rocketman051894/LoraSMS/Hardware/Power Analsys.xlsx

Device | Current (mA) | Voltage | Power
ATMega | 12 | 5 | 0.06
Lora | 130 | 3.3 | 0.429
BT | 30 | 5 | 0.15
Total | 172 |  | 0.639
