rocketman051894/LoraSMS/Hardware/BOM.xls

Quantity | Designator | Description | Manufacturer | Manufacturer P/N
4 | C1, C3, C4, C5 | CAP, CER, SMT, 25V, +/- 10%, X7R, 0603 | Kemet Corporation | C0603C104K3RAC
4 | C2, C3, C8, C9 | CAP, CER, SMT, 1.0UF, 25V, 10%, X5R, 0603 | Kemet Corporation | C0603C105K3PAC
2 | C6, C7 | CAP, CER, 10%, 50V, 27PF, CAP0603 | Kemet Corporation | C0603C270K5GAC
4 | C10, C11, C17, C18 | CAP, CER, 10UF, 16V, X5R, 0805 | Murata Manufacturing Co., Ltd. | GRM21BR61C106KE15L
1 | C12 | CAP, CER, 0805, 20%, 6.3V, X5R, 47UF | Kemet Corporation | C0805C476M9PACTU
1 | C13 | CAP, CER, 5%, 25V, C0G, 0603, 10,000PF | TDK Corporation | C1608C0G1E103JT
2 | C14, C15 | CAP, CER, 0805, 20%, 10V, X7R, 22UF | Taiyo Yuden USA, Inc. | LMK212BJ226MG-T
1 | C16 | CAP RF, HIQ, NPO, +/-1%, 10GHZ, 200, 100V, 0603, 10PF, ROHS | Vishay | VJ0603D100FXBA
1 | C19 | CAP, CER, SMT, 25V, +80/-20%,Y5V,0603,.1uf | Kemet Corporation | C0603C104M3VAC
1 | D1 | DIODE, LED, RED, SMT, 2.5V, 0603 | Kingbright | APT1608SRCPRV
7 | FB1, FB2, FB3, FB4, FB5, FB6, FB7 | FERRITE,100MHZ,0603,25%,120OHM ROHS | Murata | BLM18PG121SN1D
1 | J1 | CONN, SMA JACK, FEMALE, EDGE | LINX | CONSMA003.062
1 | J2 | CONN USB 2.0 TYPE-C R/A SMT | GCT | USB4110-GF-A
2 | L1, L2 | INDUCTOR POWER 1UH 1.5A SMD | Vishay Dale | IHHP0806AZER1R0M01
2 | LED1, LED2 | LED 0603 SMD Green 570nm 50mcd 20mA | Wurth Electronics | 150060VS75000
2 | M1, M2 | MOSFET N-CH 30V 14A POWER56 | ON Semiconductor | FDMS7692
4 | MH1, MH2, MH3, MH4 | Mounting Hole
1 | P1 | Header, 3-Pin, Dual row
1 | P2 | HC-05 BLUETOOTH MODULE
1 | Q1 | TRANS,BJT,PNP,3906,SOT-23 | Fairchild Semiconductor | MMBT3906
2 | R1, R24 | RES, THICK FILM CHIP, SMT, 1/10W, 1%, 0603, 100K OHM | Panasonic Electronic Devices, Corp. | ERJ3EKF1003V
17 | R2, R3, R5, R6, R7, R8, R9, R10, R11, R12, R13, R14, R15, R16, R17, R27, R32 | RES, THICK FILM CHIP, 1/16W, 1%, RES0402, 0 OHM, ROHS, SHORT-IN-PAD! | Vishay-Dale Intertechnology, Inc | CRCW04020000Z0ED
2 | R4, R29 | RES, THICK FILM CHIP, SMT, 1/10W, 5%, 0603, 10K OHM | Vishay-Dale Intertechnology, Inc | CRCW060310K0JNEA
1 | R18 | RES, 1/10W, 5%, 0603, I MEG | KOA-Speer Electronics, Inc. | RM73B1JT105J
1 | R19 | RES, 1/8W, 5%, 0805, 330 OHM | KOA-Speer Electronics, Inc. | RM73B2AT331J
2 | R20, R25 | RES, THICK FILM CHIP, SMT, 1/10W, 5%, 0603, 510 OHM | Panasonic Electronic Devices, Corp. | ERJ3GEYJ511V
1 | R21 | RES, 1/16 W, 1%, 0603, 330 OHM | Panasonic Electronic Devices, Corp. | ERJ-3ENF3300V
1 | R22 | RES, THICK FILM CHIP, SMT, 1/10W, 1%, 0603, 316K OHM | Panasonic Electronic Devices, Corp. | ERJ3EKF3163V
1 | R23 | RES, 1/10W, 5%, 0603, 2.2K OHM | KOA-Speer Electronics, Inc. | RM73B1JT222J
1 | R26 | RES, 1/16W, 1%, 0603, 2.00K OHM | Panasonic Electronic Devices, Corp. | ERJ-3EKF2001V
2 | R28, R31 | RES, THICK FILM CHIP, SMT, 1/10W, 1%, 0603, 5.1 OHM | Panasonic Electronic Devices, Corp. | ERJ-3EKF5R1V
1 | R30 | RES, THICK FILM, CURRENT SENSE, 1/2 W, 1%, RES1206, 0.05 OHMS | TT Electronics, PLC | LRC-LR1206LF-01-R050-F
1 | R33 | RES,1/10W,1%,0603,100K OHM | Panasonic Electronic Devices, Corp. | ERJ-3EKF1003V
1 | R34 | RES, METAL FILM, 1/16W, .5%, 0603, SMD, 4.02K | Susumu | RR0816P-4021-D-59H
1 | SW1 | SWITCH SLIDE DPDT 300MA 6V | JS202011JAQN | C&K
1 | U1 | RFM69HCW WIRELESS TRANSCEIVER 91 | SparkFun | COM-13909
1 | U2 | 8-bit AVR Microcontroller, 32KB Flash, 1KB EEPROM, 2KB SRAM, 32-pin TQFP, Industrial Grade (-40°C to 85°C) | Microchip Technology | ATMEGA328PB-AU
1 | U3 | IC LI-ION/LI-POLY CTRLR SOT23-5 | Microchip Technology | MCP73812T-420I/OT
1 | U4 | TPS630242YFFR | TI | TPS630242YFFR
1 | U5 | HOLDER BATTERY 1CELL 18650 SMD | Keystone Electronics | 1042
1 | U6 | TPS61230ARNSR | TI | TPS61230ARNSR
1 | U7 | IC LITHIUM BATT PROTECT 6-SON | Texas instruments | BQ29702DSER
1 | U8 | LOW COST CURRENT SENSOR WITH COM | TI | INA381A3IDSGR
1 | Y1 | CRYSTAL 16.0000MHZ 8PF SMD
