rocketman051894/LoraSMS/Hardware/Digikey Cart 2019-09-24T211540.xlsx

Index | Quantity | Part Number | Manufacturer Part Number | Description | Customer Reference | Available | Backorder | Unit Price | Extended Price USD
1 | 4 | 399-7846-1-ND | C0603C105K3PACTU | CAP CER 1UF 25V X5R 0603 |  | 4 | 0 | 0.21 | 0.84
2 | 2 | 399-7889-1-ND | C0603C270K5GACTU | CAP CER 27PF 50V C0G/NP0 0603 |  | 2 | 0 | 0.1 | 0.20
3 | 4 | 490-3886-1-ND | GRM21BR61C106KE15L | CAP CER 10UF 16V X5R 0805 |  | 4 | 0 | 0.32 | 1.28
4 | 1 | 399-5506-1-ND | C0805C476M9PACTU | CAP CER 47UF 6.3V X5R 0805 |  | 1 | 0 | 0.94 | 0.94
5 | 2 | 587-1958-1-ND | LMK212BJ226MG-T | CAP CER 22UF 10V X5R 0805 |  | 2 | 0 | 0.45 | 0.90
6 | 1 | 754-1122-1-ND | APT1608SRCPRV | LED RED CLEAR CHIP SMD |  | 1 | 0 | 0.38 | 0.38
7 | 1 | CONSMA003.062-ND | CONSMA003.062 | CONN SMA RCPT STR 50OHM EDGE MNT |  | 1 | 0 | 3.76 | 3.76
8 | 1 | 2073-USB4110-GF-A-1-ND | USB4110-GF-A | CONN USB 2.0 TYPE-C R/A SMT |  | 1 | 0 | 1.37 | 1.37
9 | 2 | 541-2647-1-ND | IHHP0806AZER1R0M01 | FIXED IND 1UH 3.1A 65 MOHM SMD |  | 2 | 0 | 0.42 | 0.84
10 | 2 | 732-4980-1-ND | 150060VS75000 | LED GREEN CLEAR 0603 SMD |  | 2 | 0 | 0.14 | 0.28
11 | 2 | FDMS7692CT-ND | FDMS7692 | MOSFET N-CH 30V 14A POWER56 |  | 2 | 0 | 0.66 | 1.32
12 | 2 | P100KHCT-ND | ERJ-3EKF1003V | RES SMD 100K OHM 1% 1/10W 0603 |  | 2 | 0 | 0.1 | 0.20
13 | 2 | 541-10KGCT-ND | CRCW060310K0JNEA | RES SMD 10K OHM 5% 1/10W 0603 |  | 2 | 0 | 0.1 | 0.20
14 | 1 | A130109CT-ND | CRGCQ0603J1M0 | CRGCQ 0603 1M0 5% |  | 1 | 0 | 0.1 | 0.10
15 | 1 | CR0603-JW-331ELFCT-ND | CR0603-JW-331ELF | RES SMD 330 OHM 5% 1/10W 0603 |  | 1 | 0 | 0.1 | 0.10
16 | 2 | P510GCT-ND | ERJ-3GEYJ511V | RES SMD 510 OHM 5% 1/10W 0603 |  | 2 | 0 | 0.1 | 0.20
17 | 10 | CR0603-JW-331ELFCT-ND | CR0603-JW-331ELF | RES SMD 330 OHM 5% 1/10W 0603 |  | 10 | 0 | 0.015 | 0.15
18 | 1 | P316KHCT-ND | ERJ-3EKF3163V | RES SMD 316K OHM 1% 1/10W 0603 |  | 1 | 0 | 0.1 | 0.10
19 | 1 | A130093CT-ND | CRGCQ0603J2K2 | CRGCQ 0603 2K2 5% |  | 1 | 0 | 0.1 | 0.10
20 | 1 | P2.00KHCT-ND | ERJ-3EKF2001V | RES SMD 2K OHM 1% 1/10W 0603 |  | 1 | 0 | 0.1 | 0.10
21 | 2 | RHM5.1DCT-ND | ESR03EZPJ5R1 | RES SMD 5.1 OHM 5% 1/4W 0603 |  | 2 | 0 | 0.1 | 0.20
22 | 1 | P18935CT-ND | ERJ-B2CFR05V | RES 0.05 OHM 1W 1206 WIDE |  | 1 | 0 | 0.68 | 0.68
23 | 1 | P100KHCT-ND | ERJ-3EKF1003V | RES SMD 100K OHM 1% 1/10W 0603 |  | 1 | 0 | 0.1 | 0.10
24 | 1 | RR08P4.02KDCT-ND | RR0816P-4021-D-59H | RES SMD 4.02KOHM 0.5% 1/16W 0603 |  | 1 | 0 | 0.11 | 0.11
25 | 1 | CKN10722CT-ND | JS202011JAQN | SWITCH SLIDE DPDT 300MA 6V |  | 1 | 0 | 0.51 | 0.51
26 | 1 | ATMEGA328PB-AU-ND | ATMEGA328PB-AU | IC MCU 8BIT 32KB FLASH 32TQFP |  | 1 | 0 | 1.38 | 1.38
27 | 1 | MCP73812T-420I/OTCT-ND | MCP73812T-420I/OT | IC LI-ION/LI-POLY CTRLR SOT23-5 |  | 1 | 0 | 0.56 | 0.56
28 | 1 | 296-40854-1-ND | TPS630242YFFT | IC REG BCK BST 3.3V 20DSBGA |  | 1 | 0 | 2.68 | 2.68
29 | 1 | 296-47375-1-ND | TPS61230ARNSR | IC REG BOOST ADJUSTABLE 6A 7VQFN |  | 1 | 0 | 1.82 | 1.82
30 | 1 | 296-39945-1-ND | BQ29702DSER | IC LITHIUM BATT PROTECT 6-SON |  | 1 | 0 | 0.69 | 0.69
31 | 4 | 399-1281-1-ND | C0603C104K3RACTU | CAP CER 0.1UF 25V X7R 0603 |  | 4 | 0 | 0.14 | 0.56
32 | 1 | 296-50476-1-ND | INA381A3IDSGR | LOW COST CURRENT SENSOR WITH COM |  | 1 | 0 | 0.75 | 0.75
33 | 1 | 311-1085-1-ND | CC0603KRX7R9BB103 | CAP CER 10000PF 50V X7R 0603 |  | 1 | 0 | 0.1 | 0.10
34 | 1 | 1276-CL10B104KB8NNNLCT-ND | CL10B104KB8NNNL | CAP CER 0.1UF 50V X7R 0603 |  | 1 | 0 | 0.1 | 0.10
35 | 1 | 311-1058-1-ND | CC0603JRNPO9BN100 | CAP CER 10PF 50V C0G/NPO 0603 |  | 1 | 0 | 0.1 | 0.10
36 | 1 | MMBT3906-TPCT-ND | MMBT3906-TP | TRANS PNP 40V 0.2A SOT23 |  | 1 | 0 | 0.14 | 0.14
37 | 1 | 36-1042P-ND | 1042P | BATTERY HOLDER 18650 SMD TAB |  | 1 | 0 | 2.76 | 2.76
38 | 10 | 490-1037-1-ND | BLM18PG121SN1D | FERRITE BEAD 120 OHM 0603 1LN |  | 10 | 0 | 0.076 | 0.76
