rocketman051894/LoraSMS/Mechanical/Bottom Case.stl

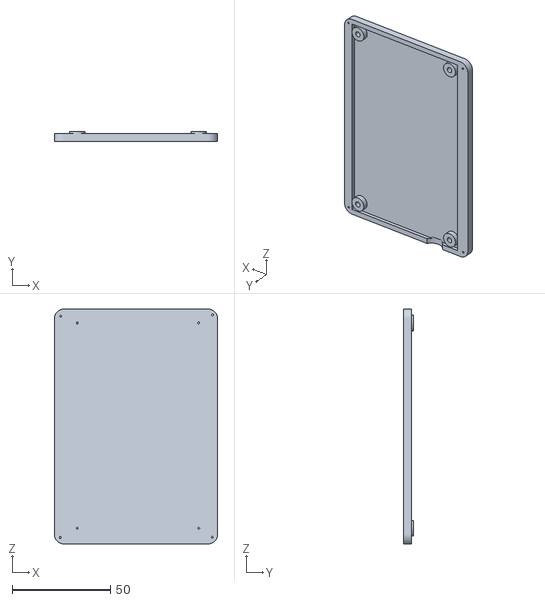
[picture p2: CAD file, 2021-03-16]
Mechanical/Bottom Case.stl
83.1 x 4.85 x 119.5
