rocketman051894/LoraSMS/Mechanical/Top Case.stl

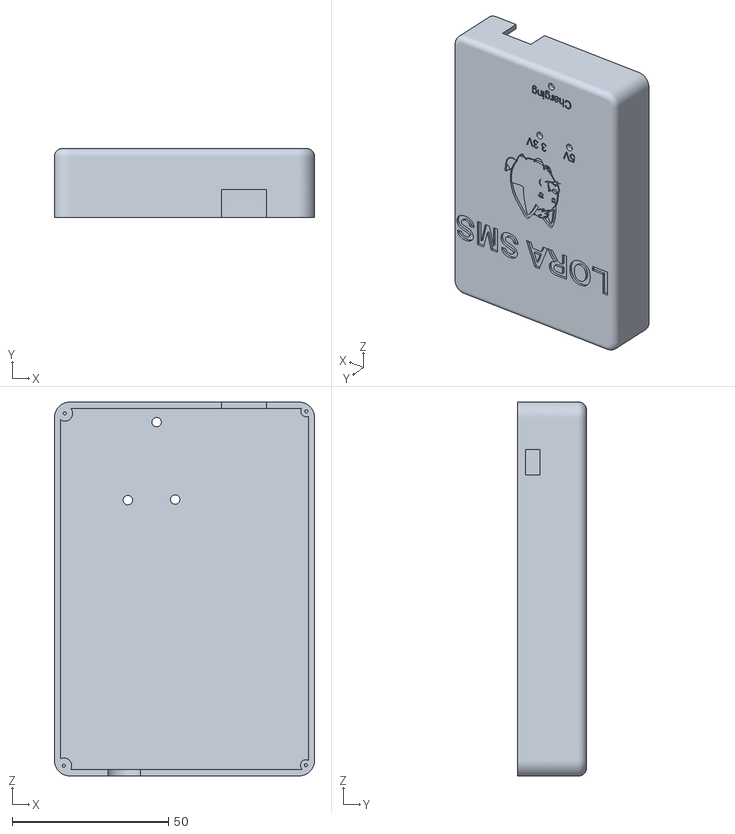
[picture p3: CAD file, 2021-03-16]
Mechanical/Top Case.stl
83.1 x 22.0 x 119.5
