rocketman051894/LoraSMS/Hardware/Schematic/Schematic_Schematic.PDF

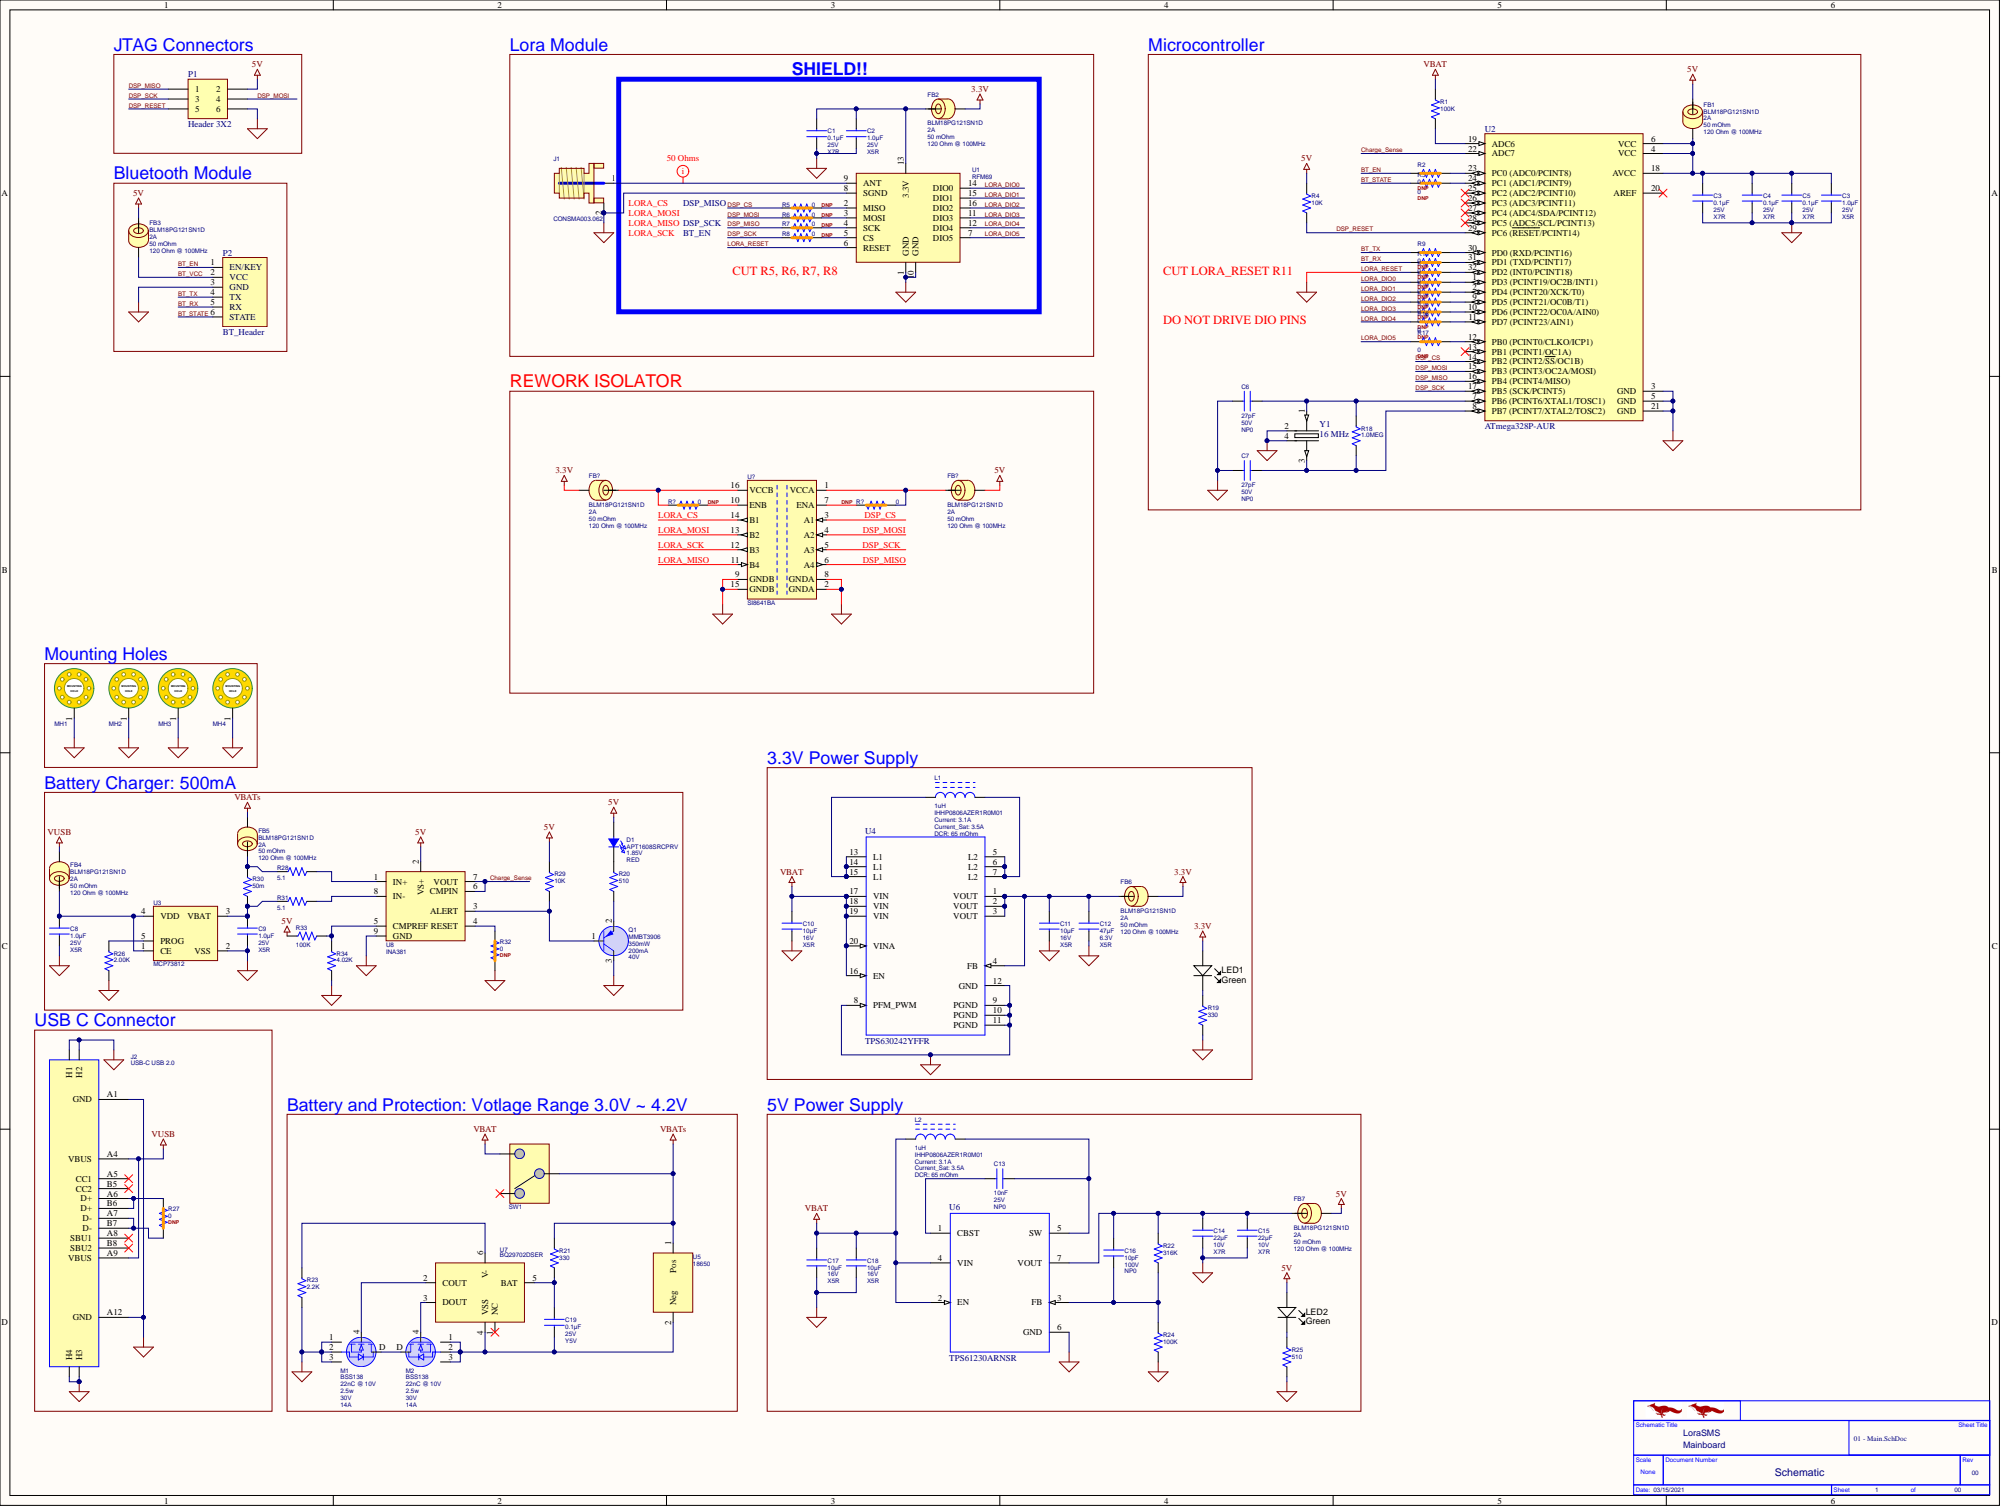
[picture p4: page 1]

GND 3

DO NOT DRIVE DIO PINS

MH1 HOLE | MH2 1 MOUNTING HOLE | MH3 1 MOUNTING HOLE | 1 MOUNTING HOLE

Battery and Protection: Votlage Range 3.0V ~ 4.2V

LoraSMS Schematic Title Mainboard | Sheet Title 01 - Main.SchDoc

Scale None | Document Number Schematic | Rev 00

Date: 03/15/2021 | Sheet 1 of 00
