rocketman051894/LoraSMS/Hardware/PCB/Assembly_Images/PCB_Assembly_Image_BW.PDF

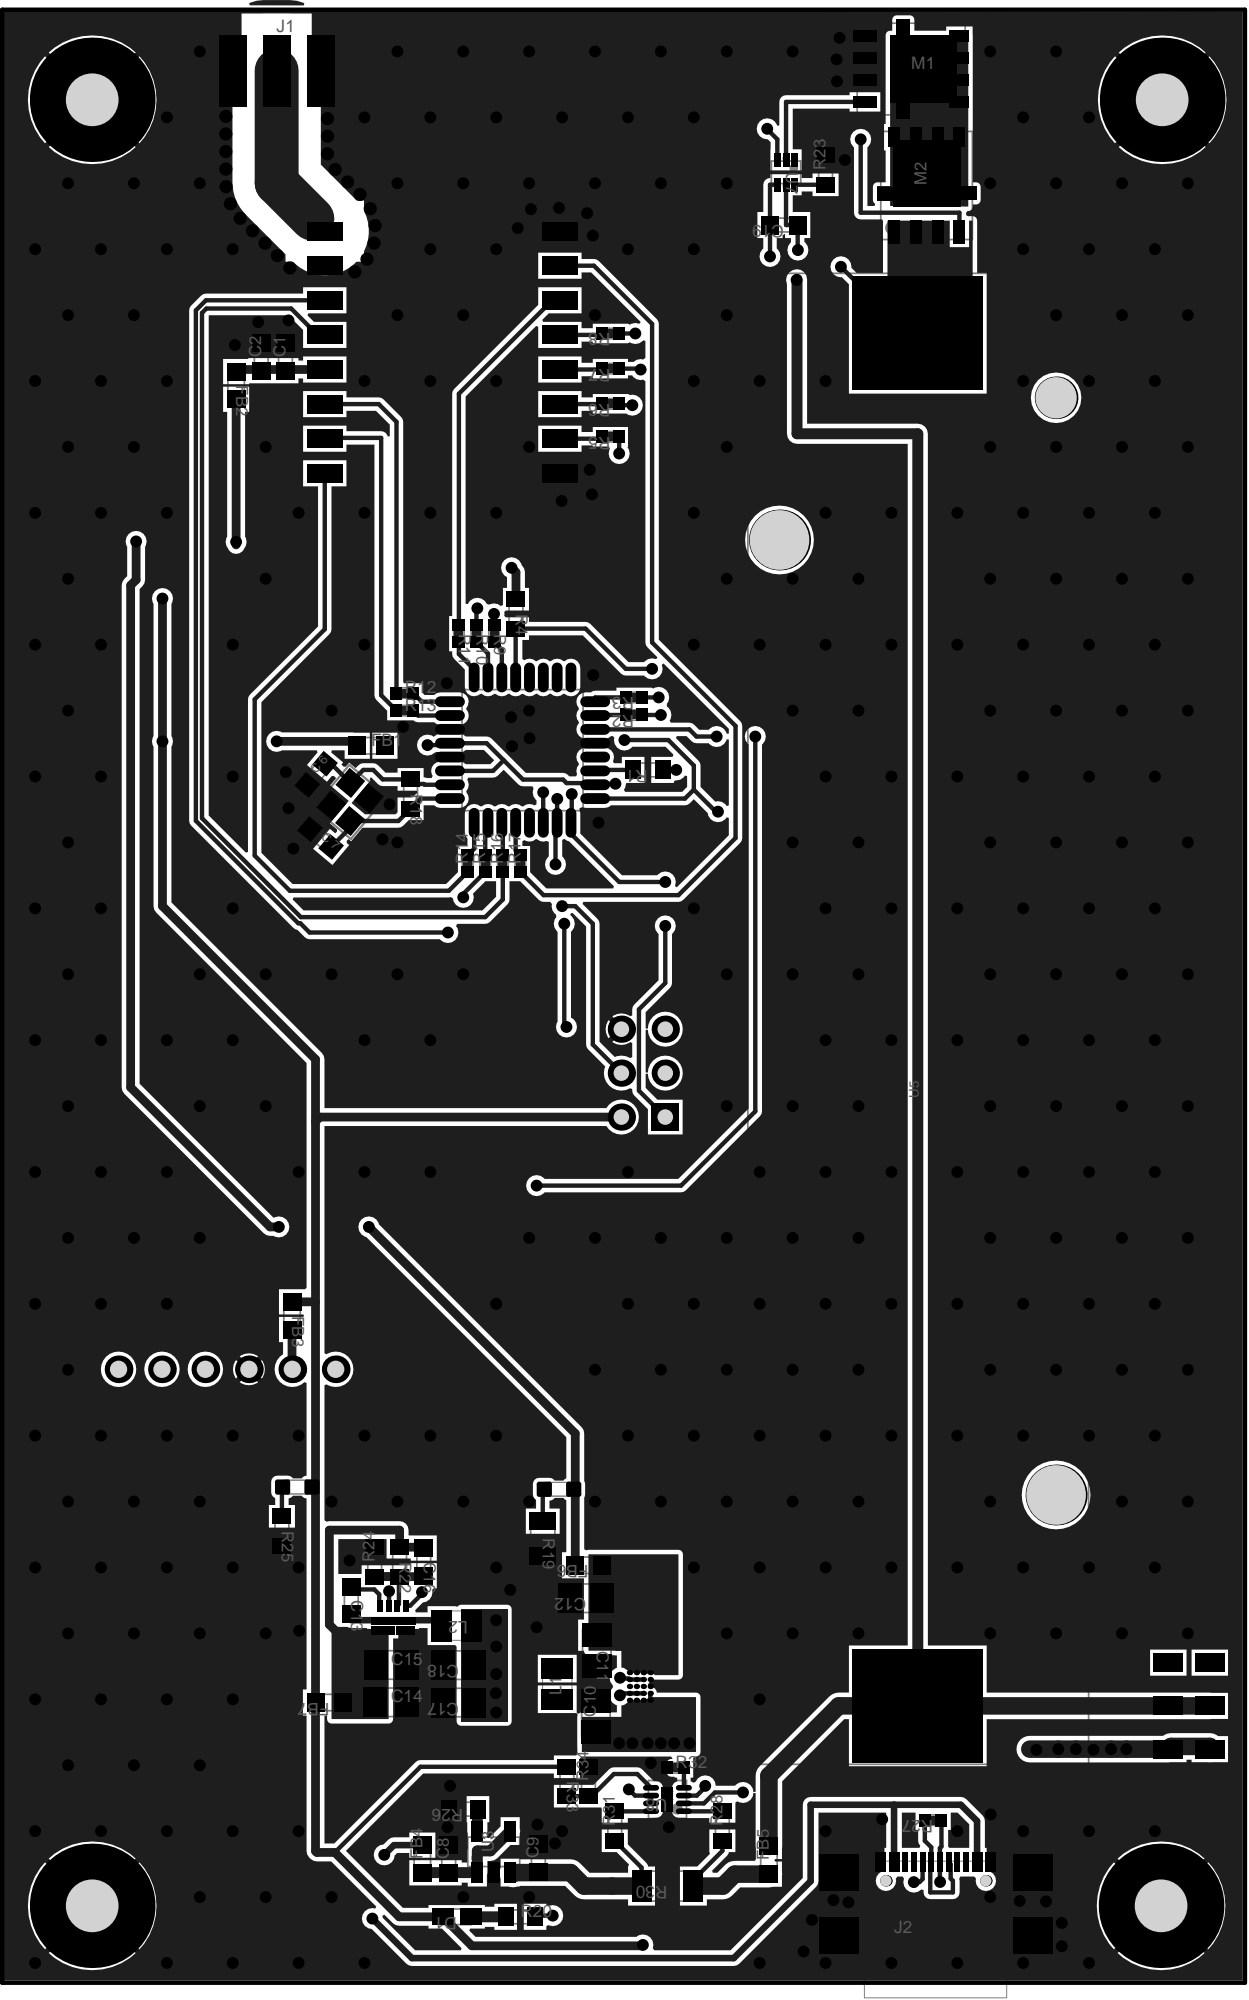
[picture p5: page 1]

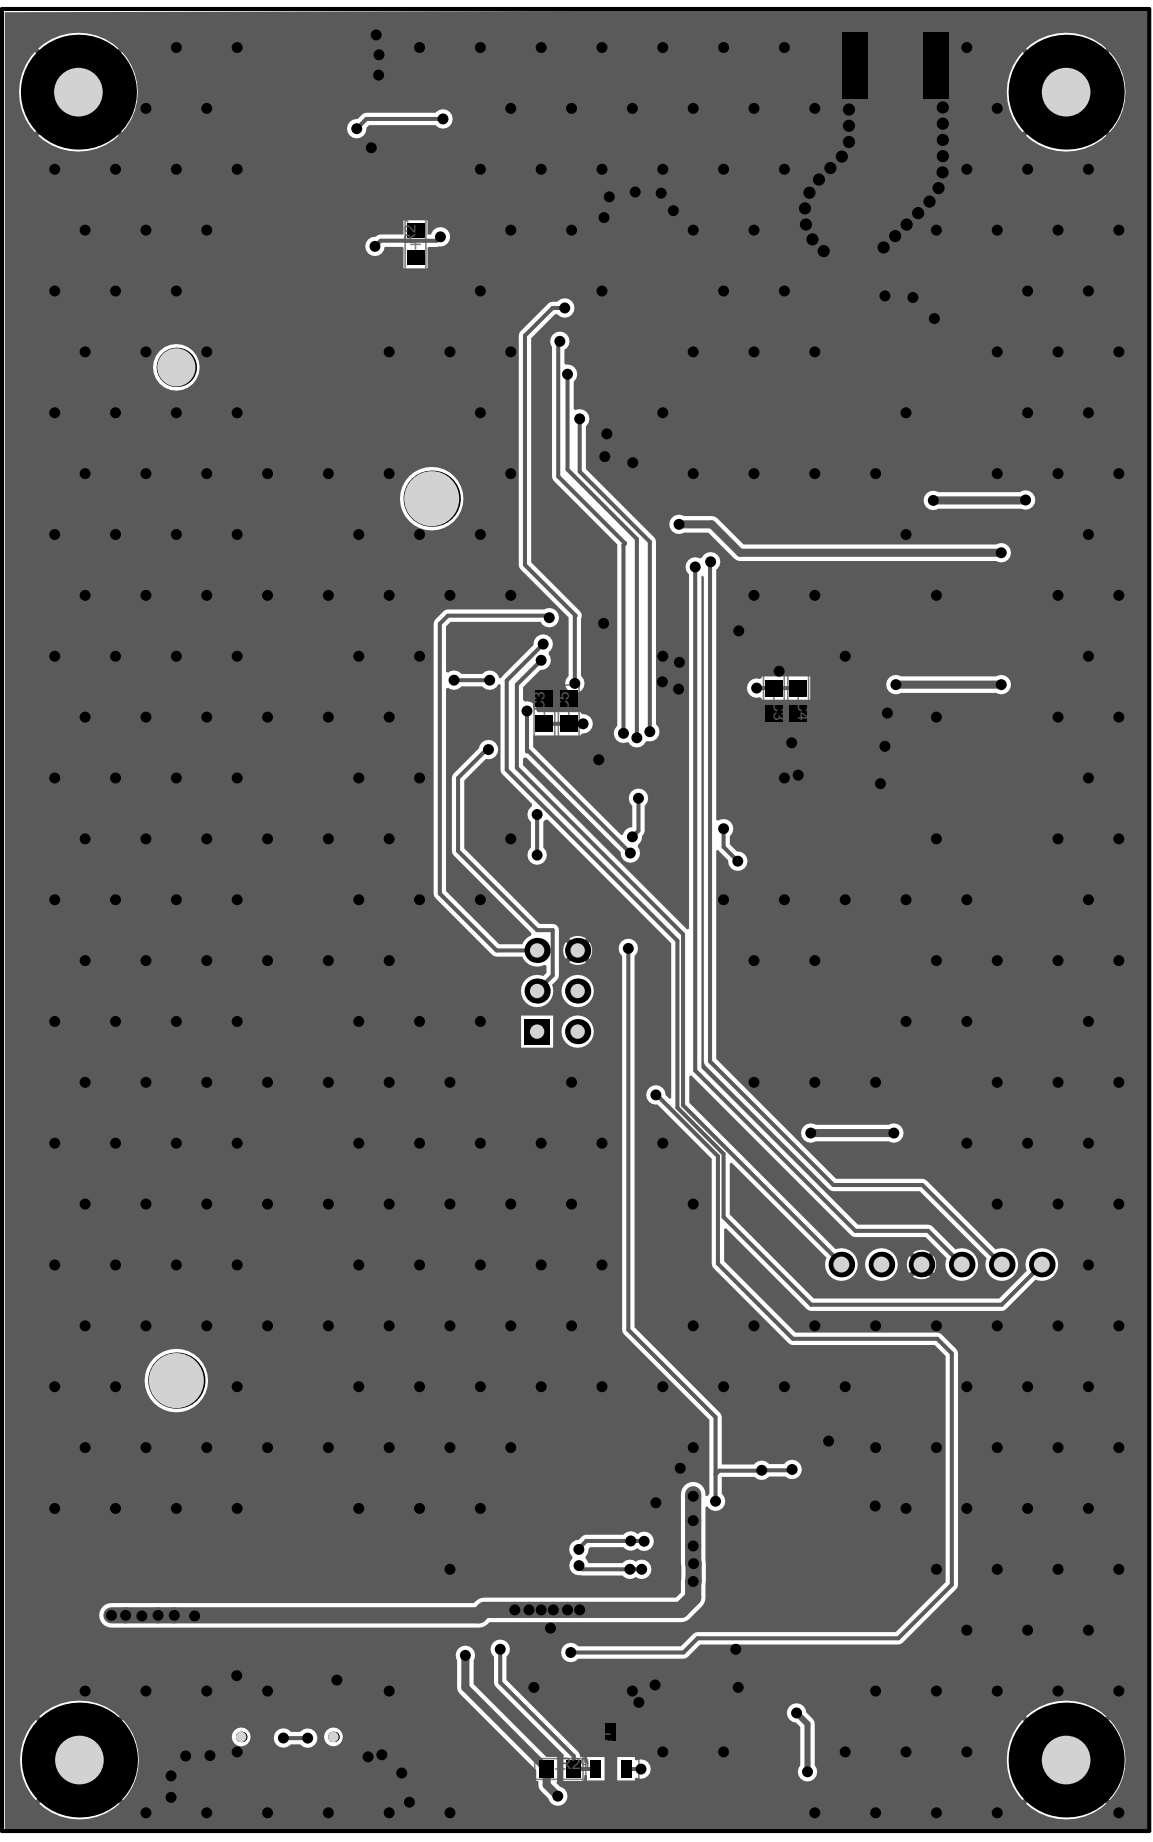
[picture p6: page 2]
