rocketman051894/LoraSMS/Hardware/PCB/Assembly_Images/PCB_Assembly_Image_BW_DNP.PDF

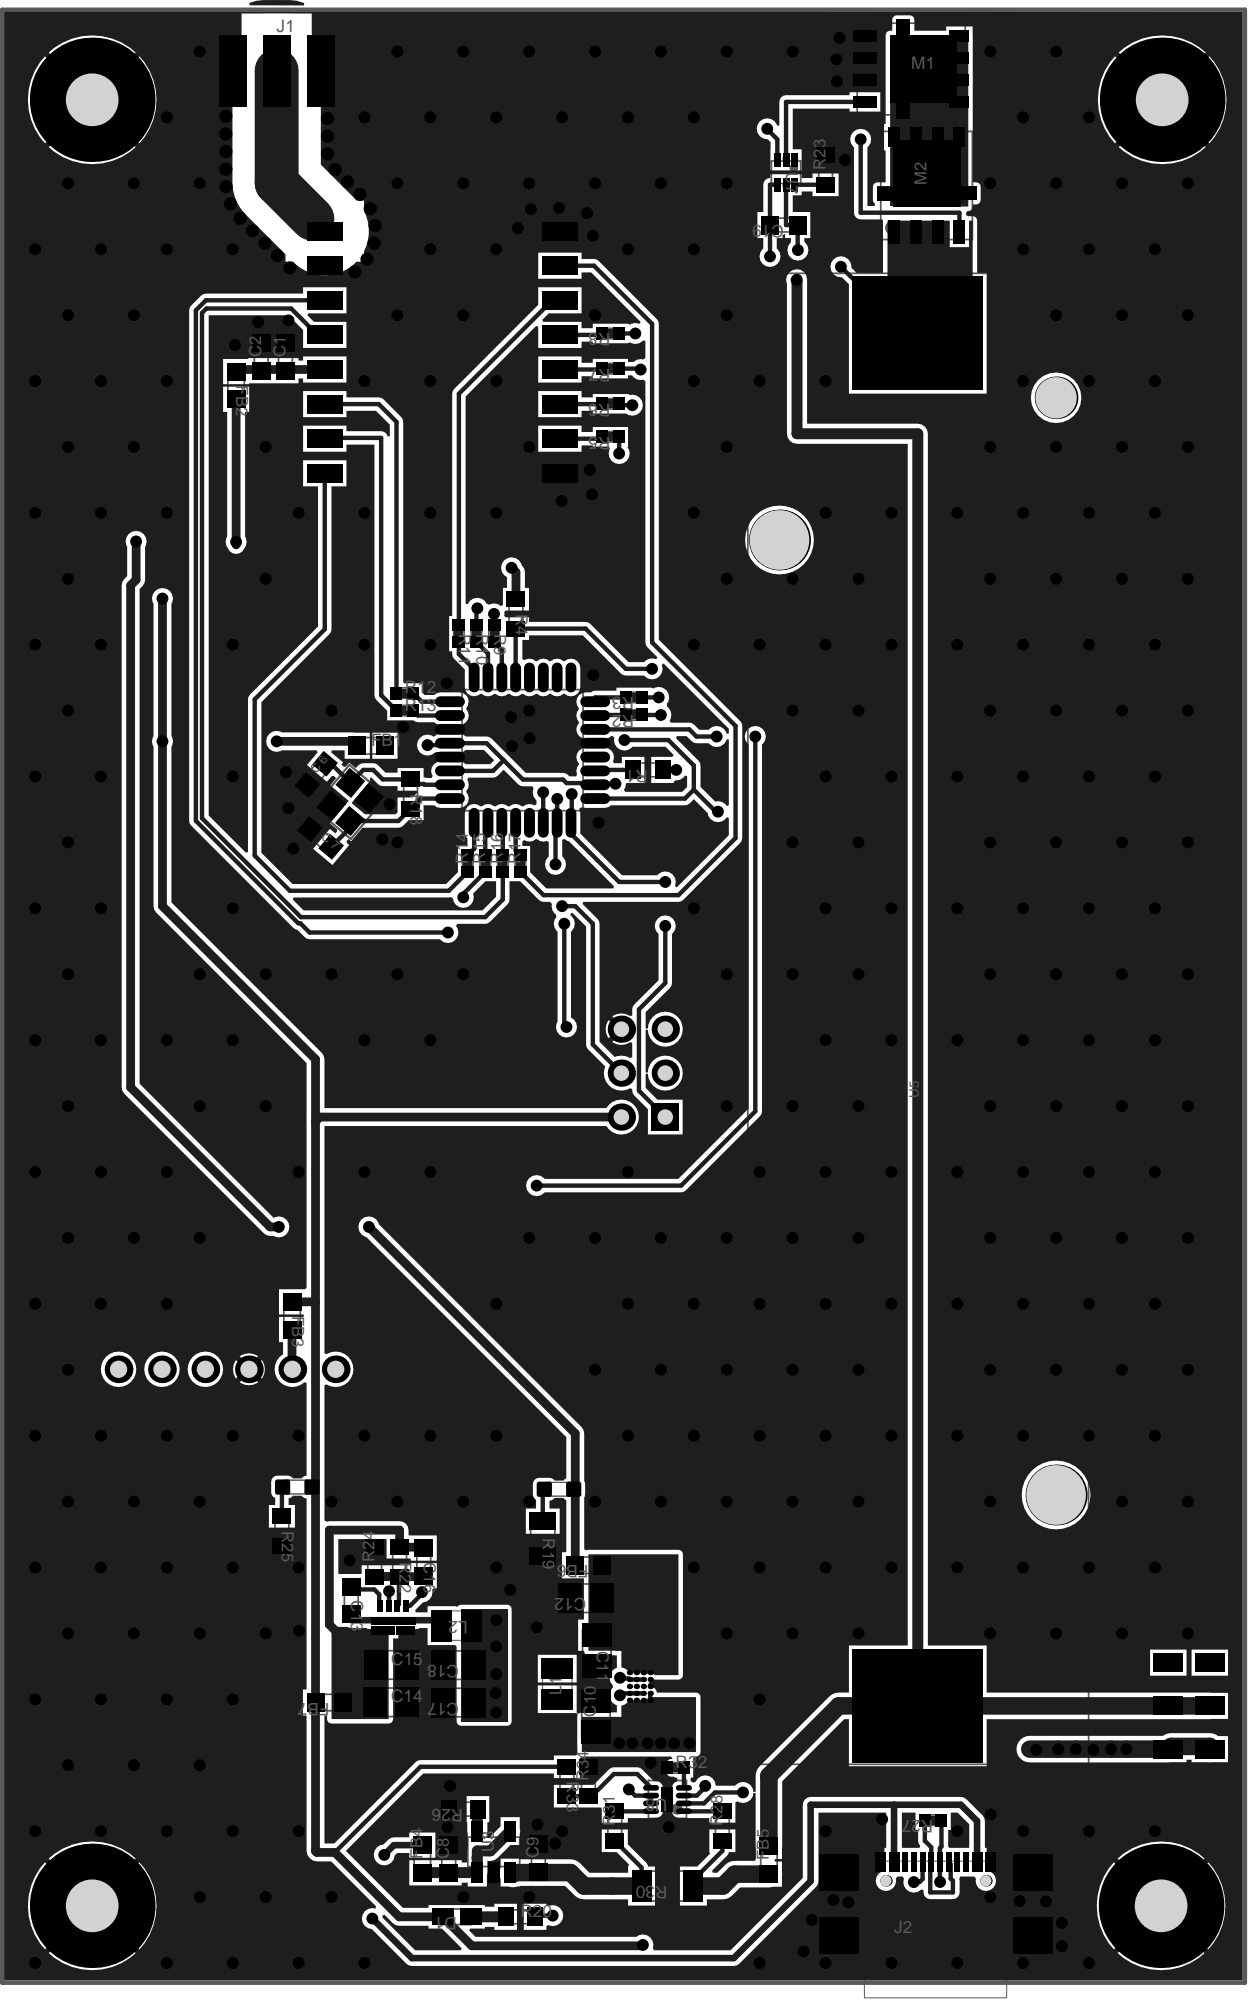
[picture p7: page 1]

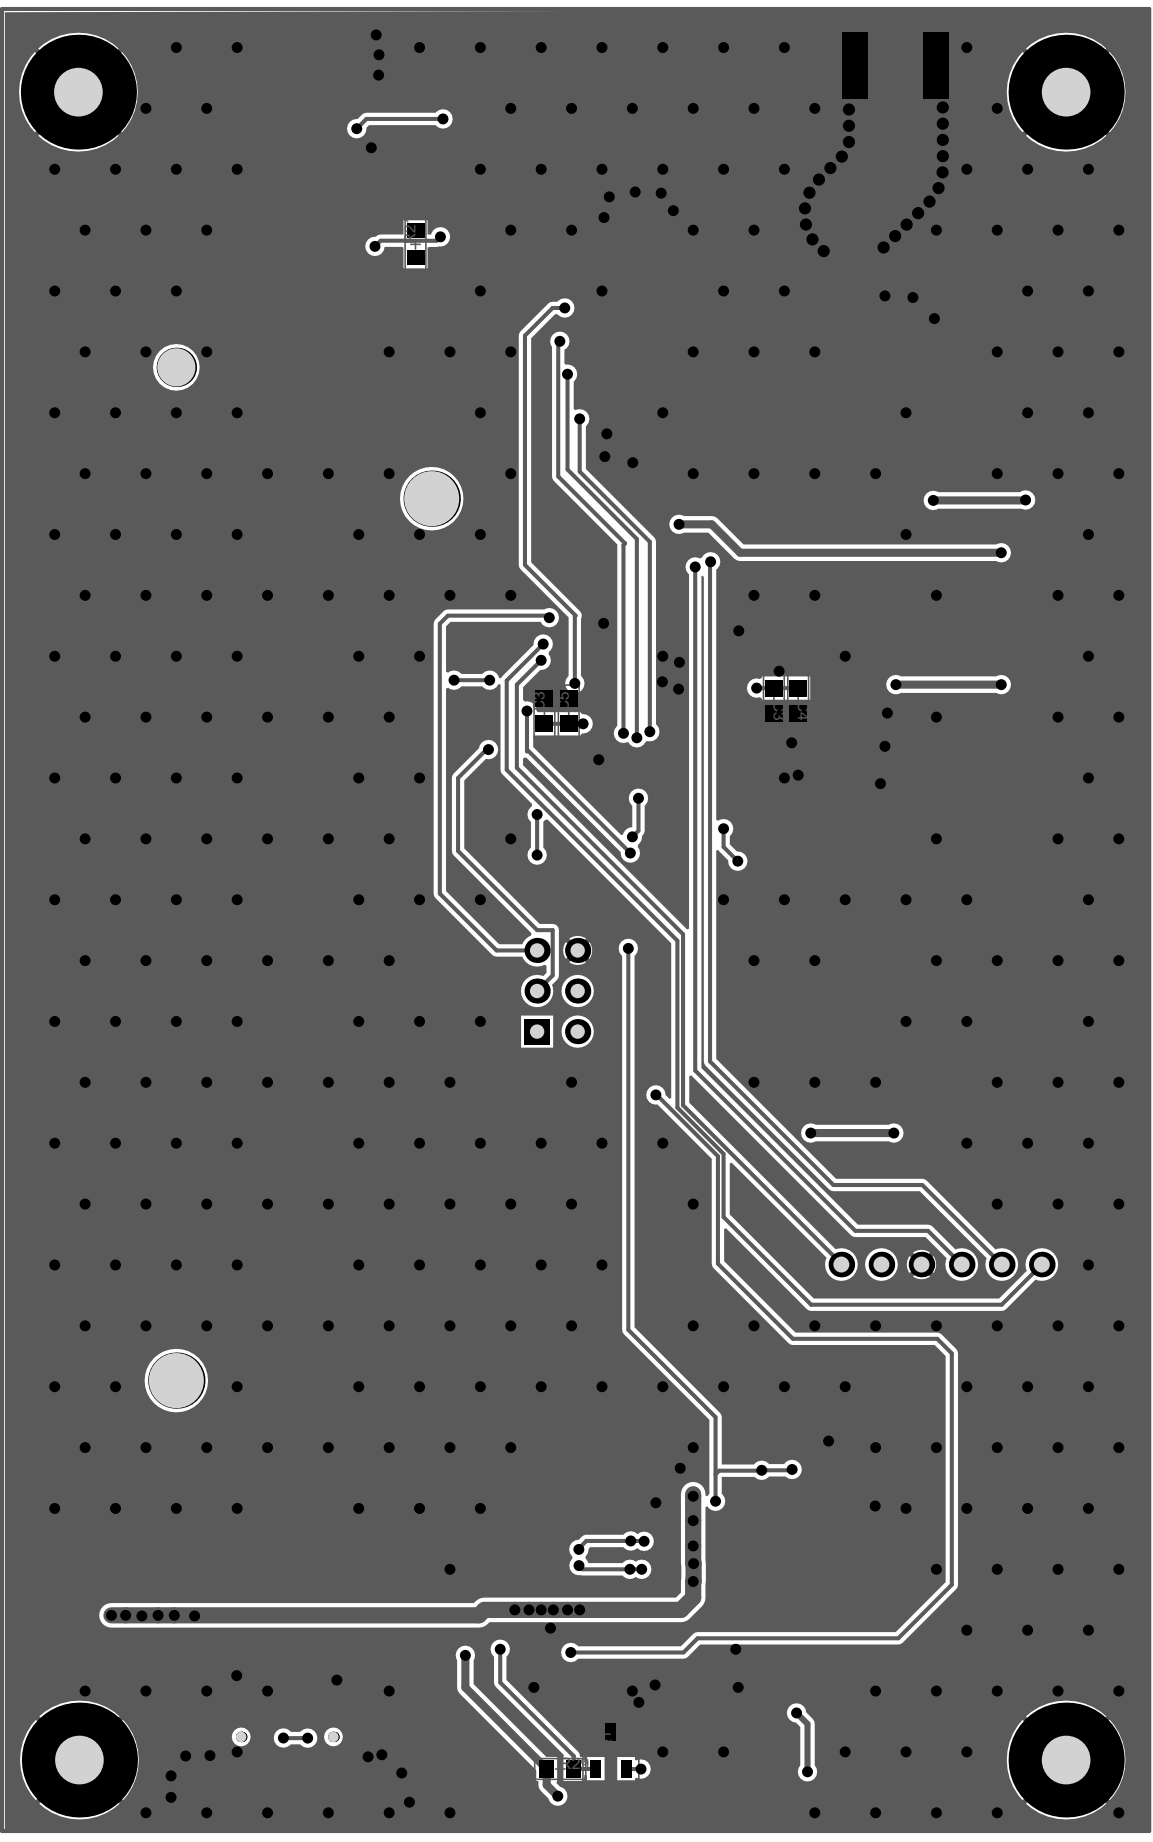
[picture p8: page 2]
