rocketman051894/LoraSMS/Hardware/PCB/Assembly_Images/PCB_Assembly_Image_Color.PDF

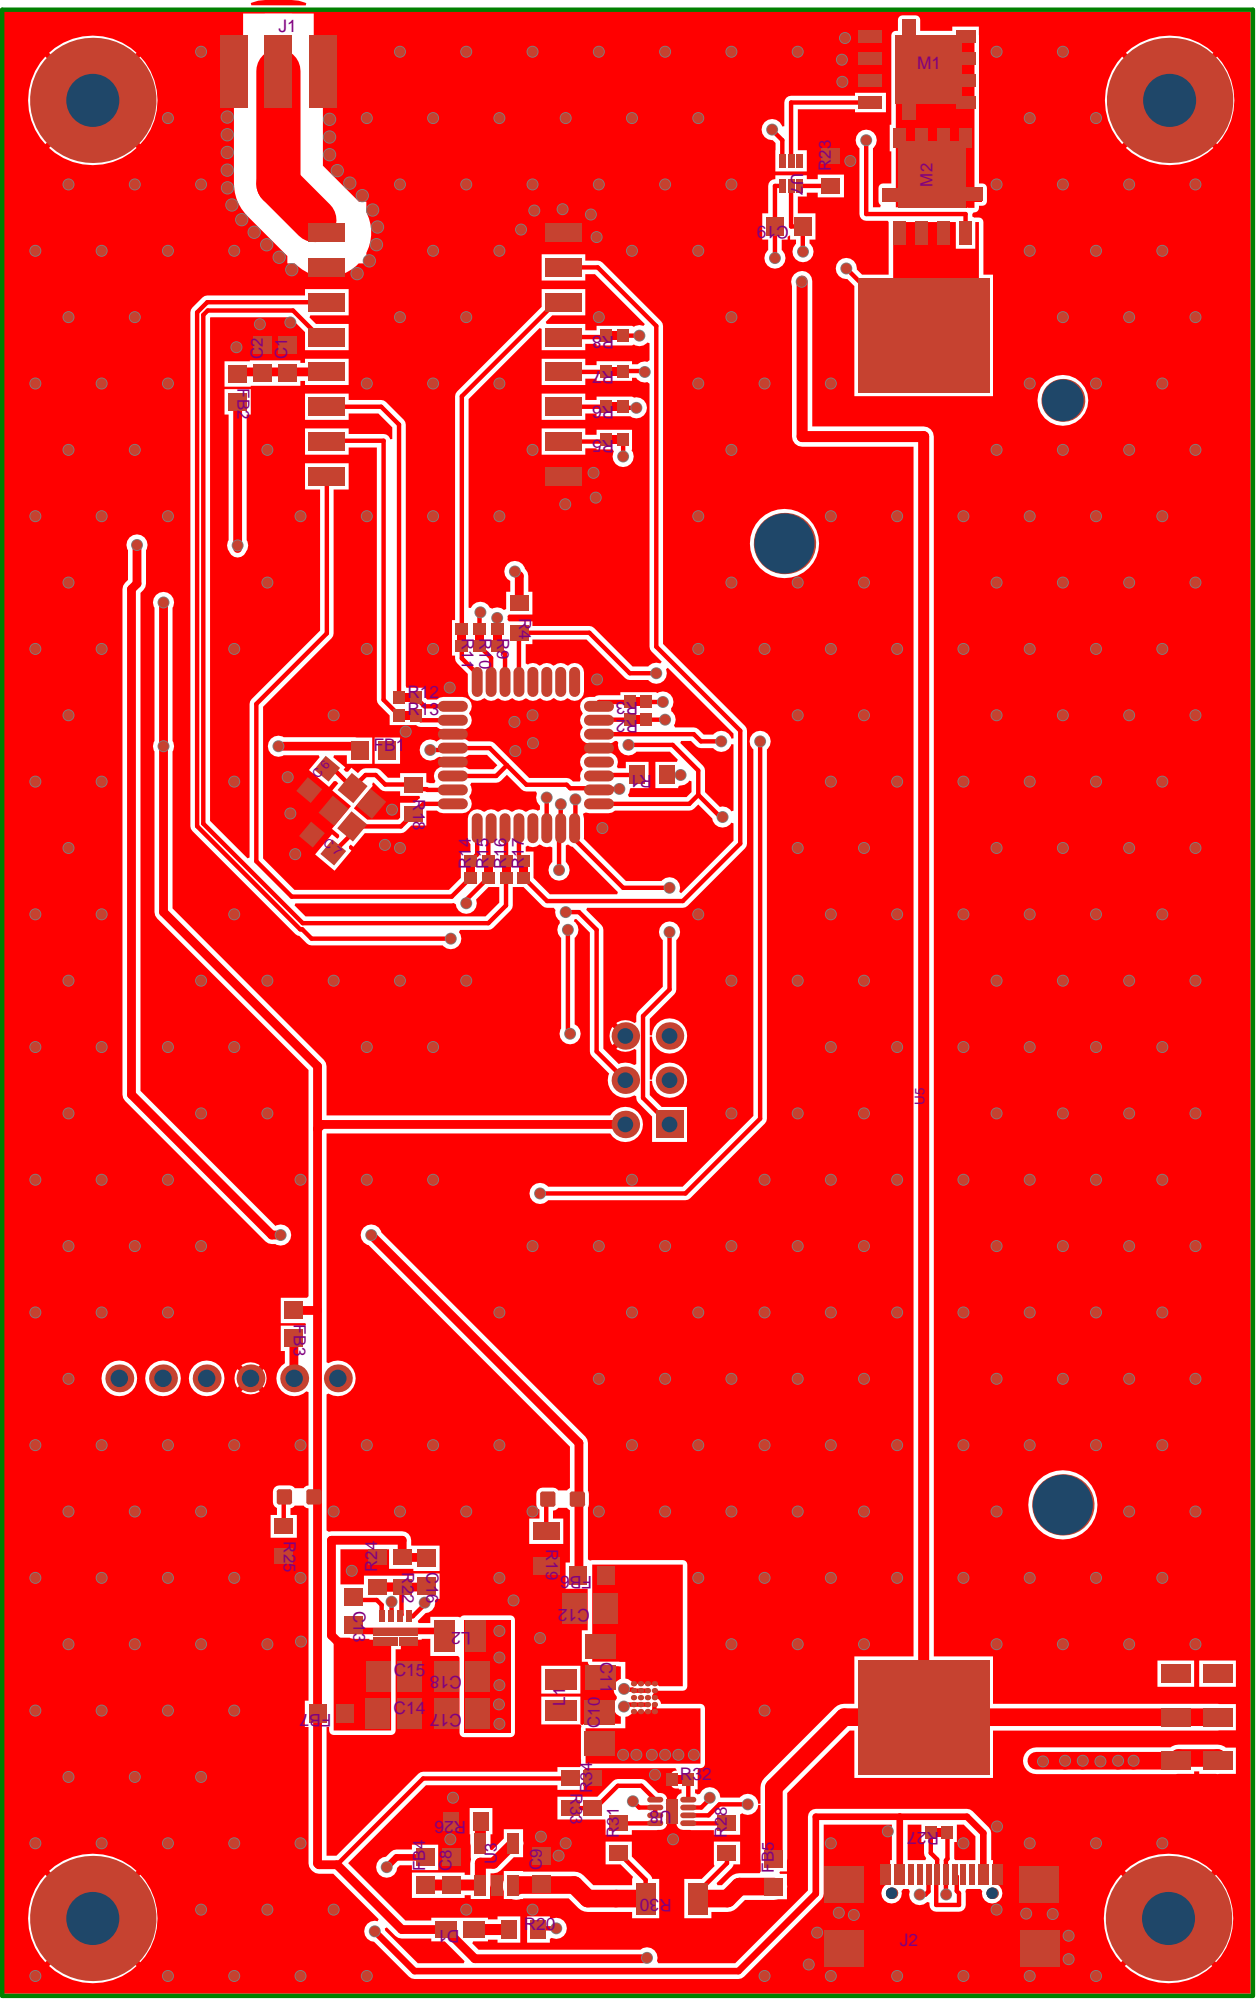
[picture p9: page 1]

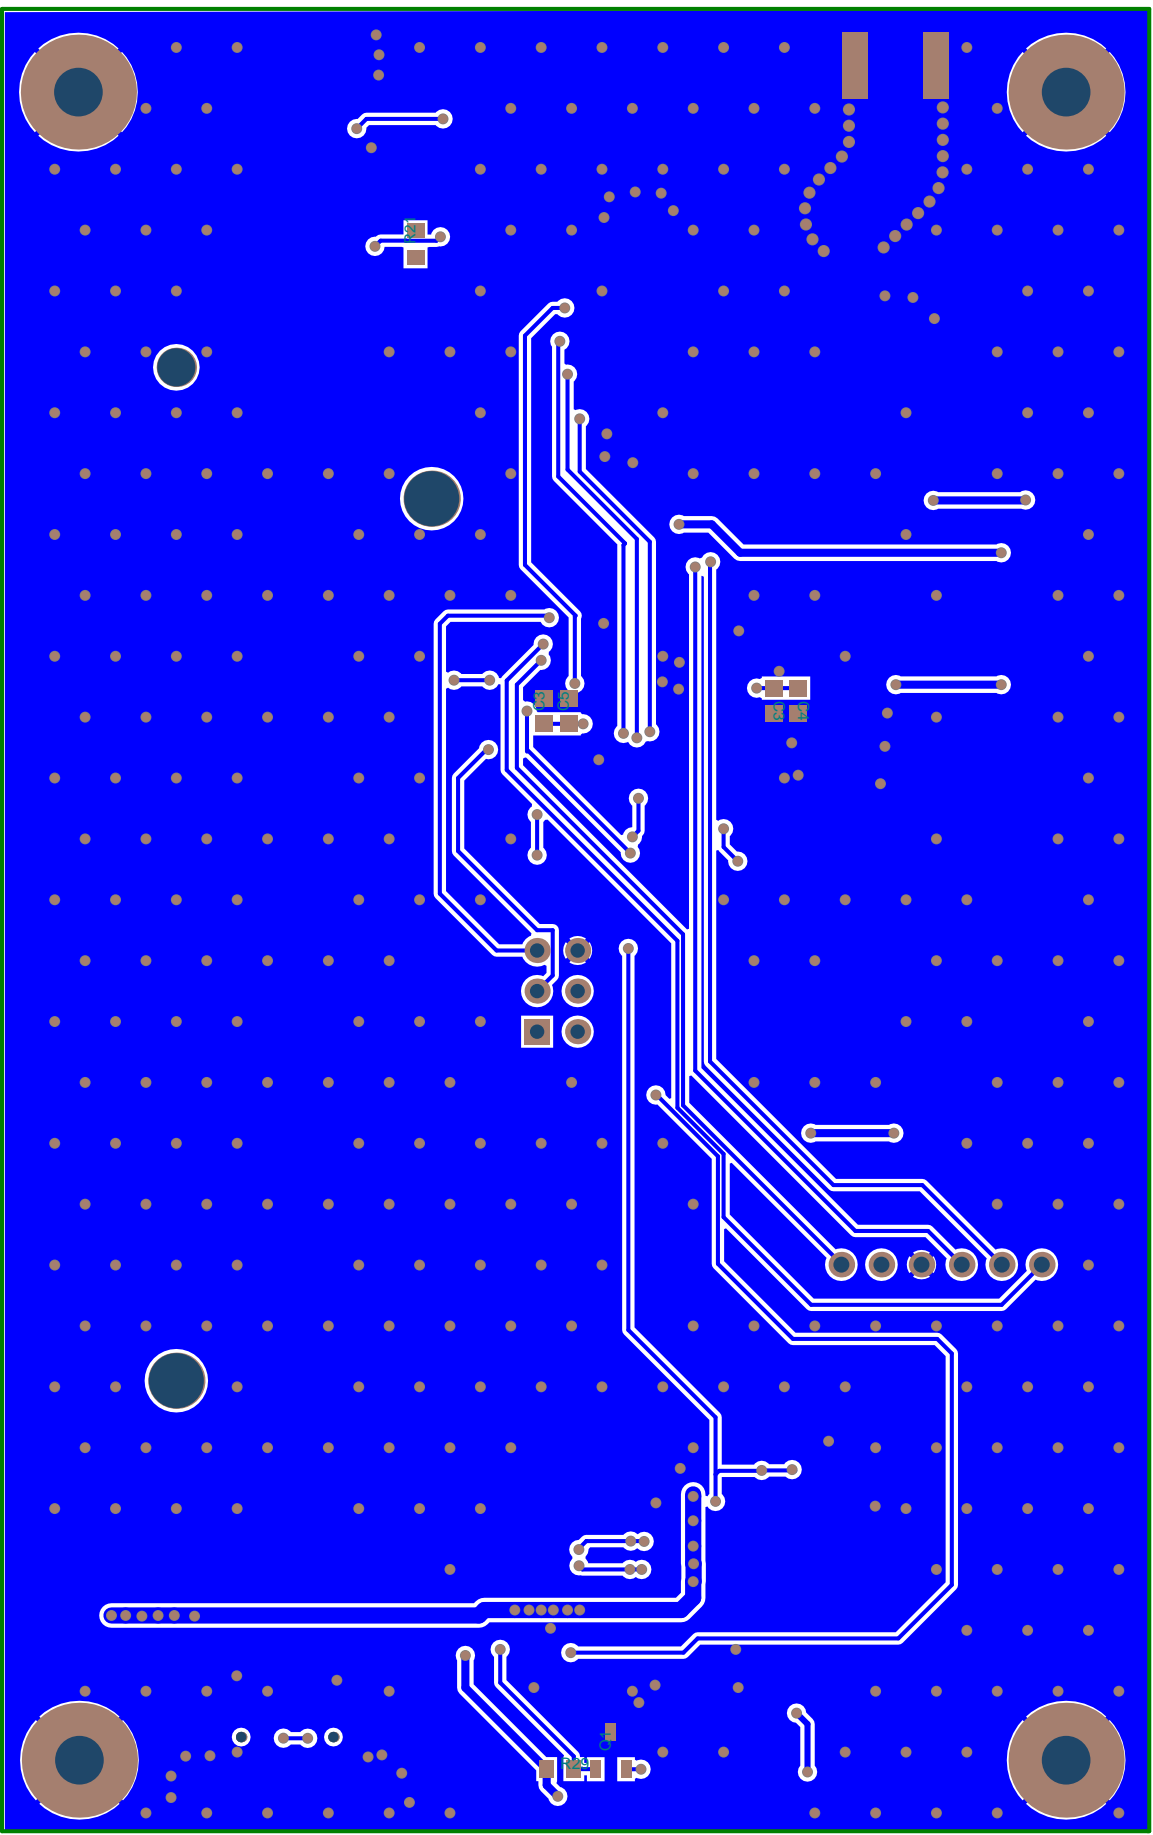
[picture p10: page 2]
