rocketman051894/LoraSMS/Hardware/PCB/Assembly_Images/PCB_Drill Drawing/Guides.PDF

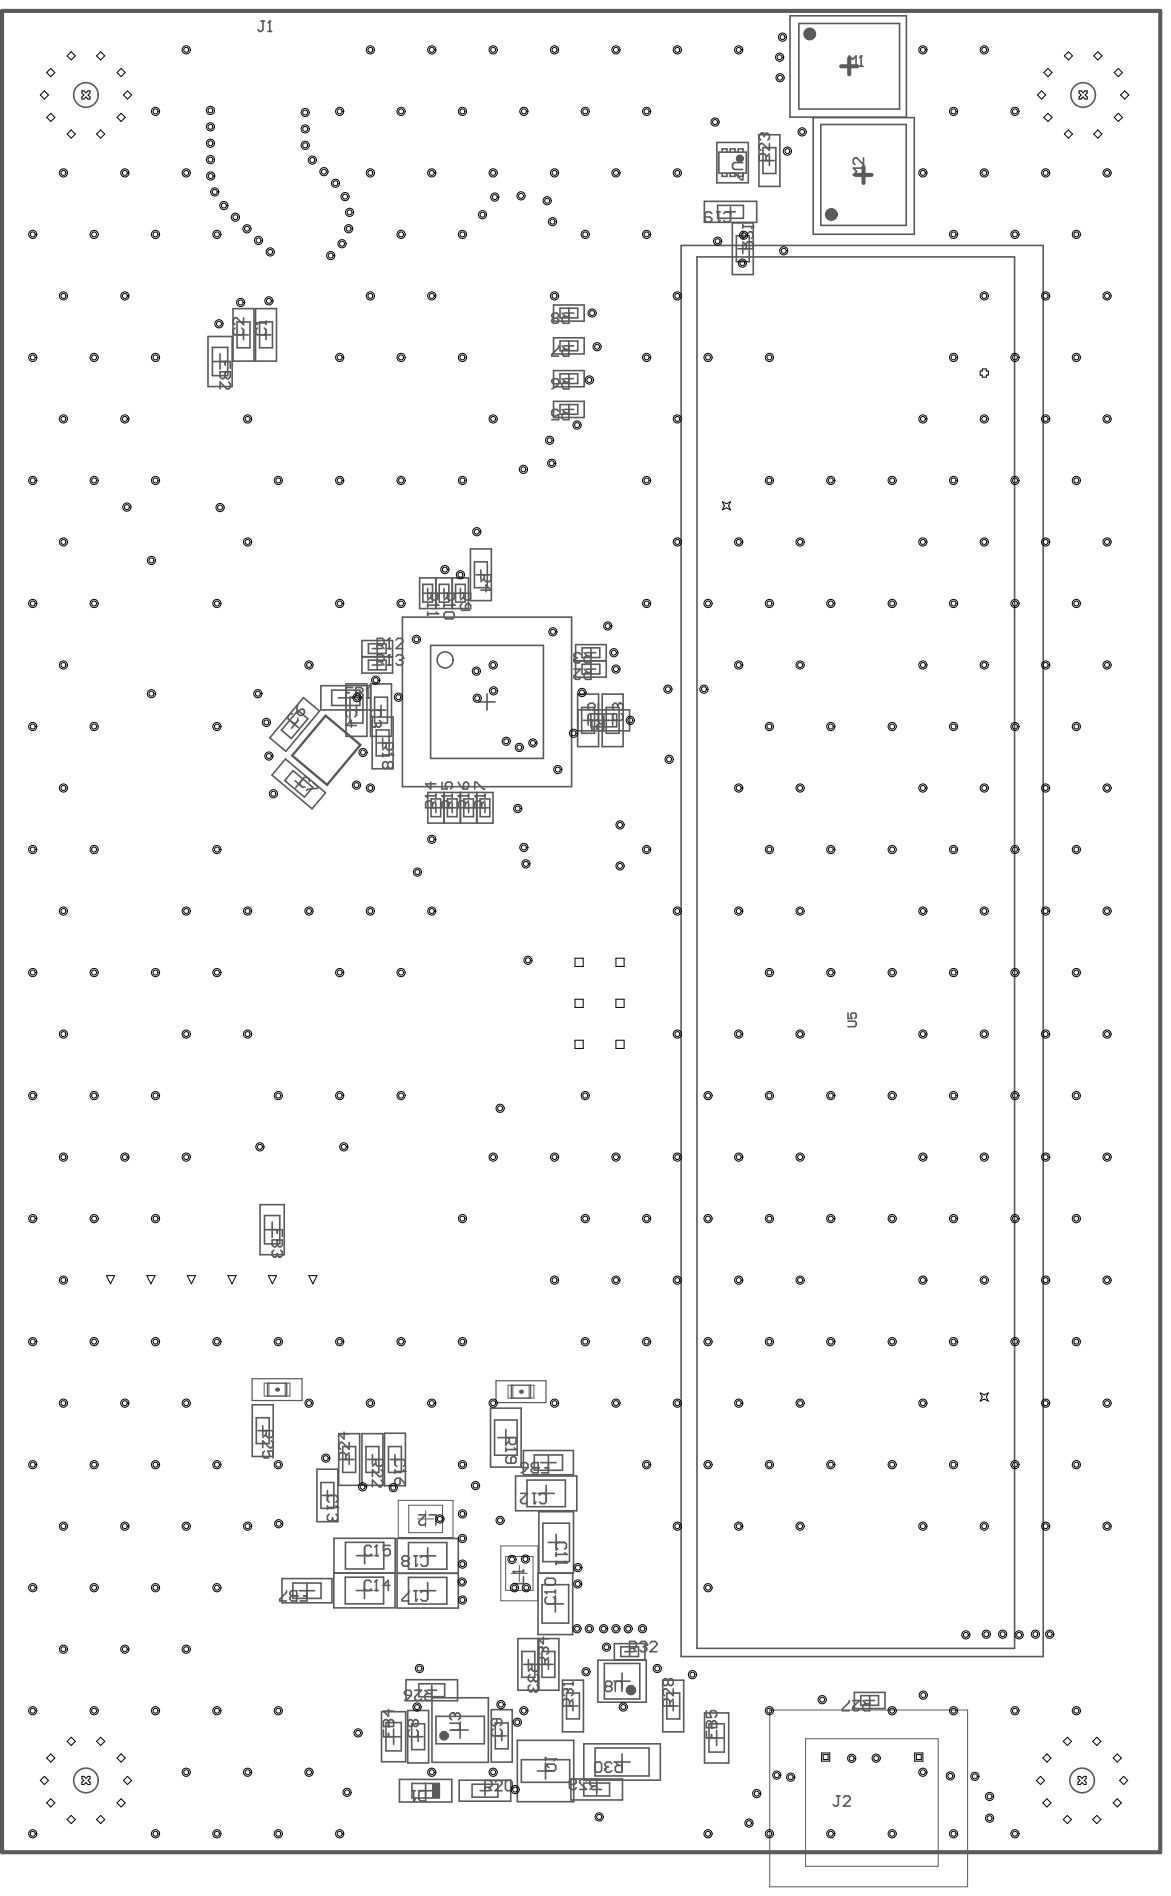
[picture p11: page 1]

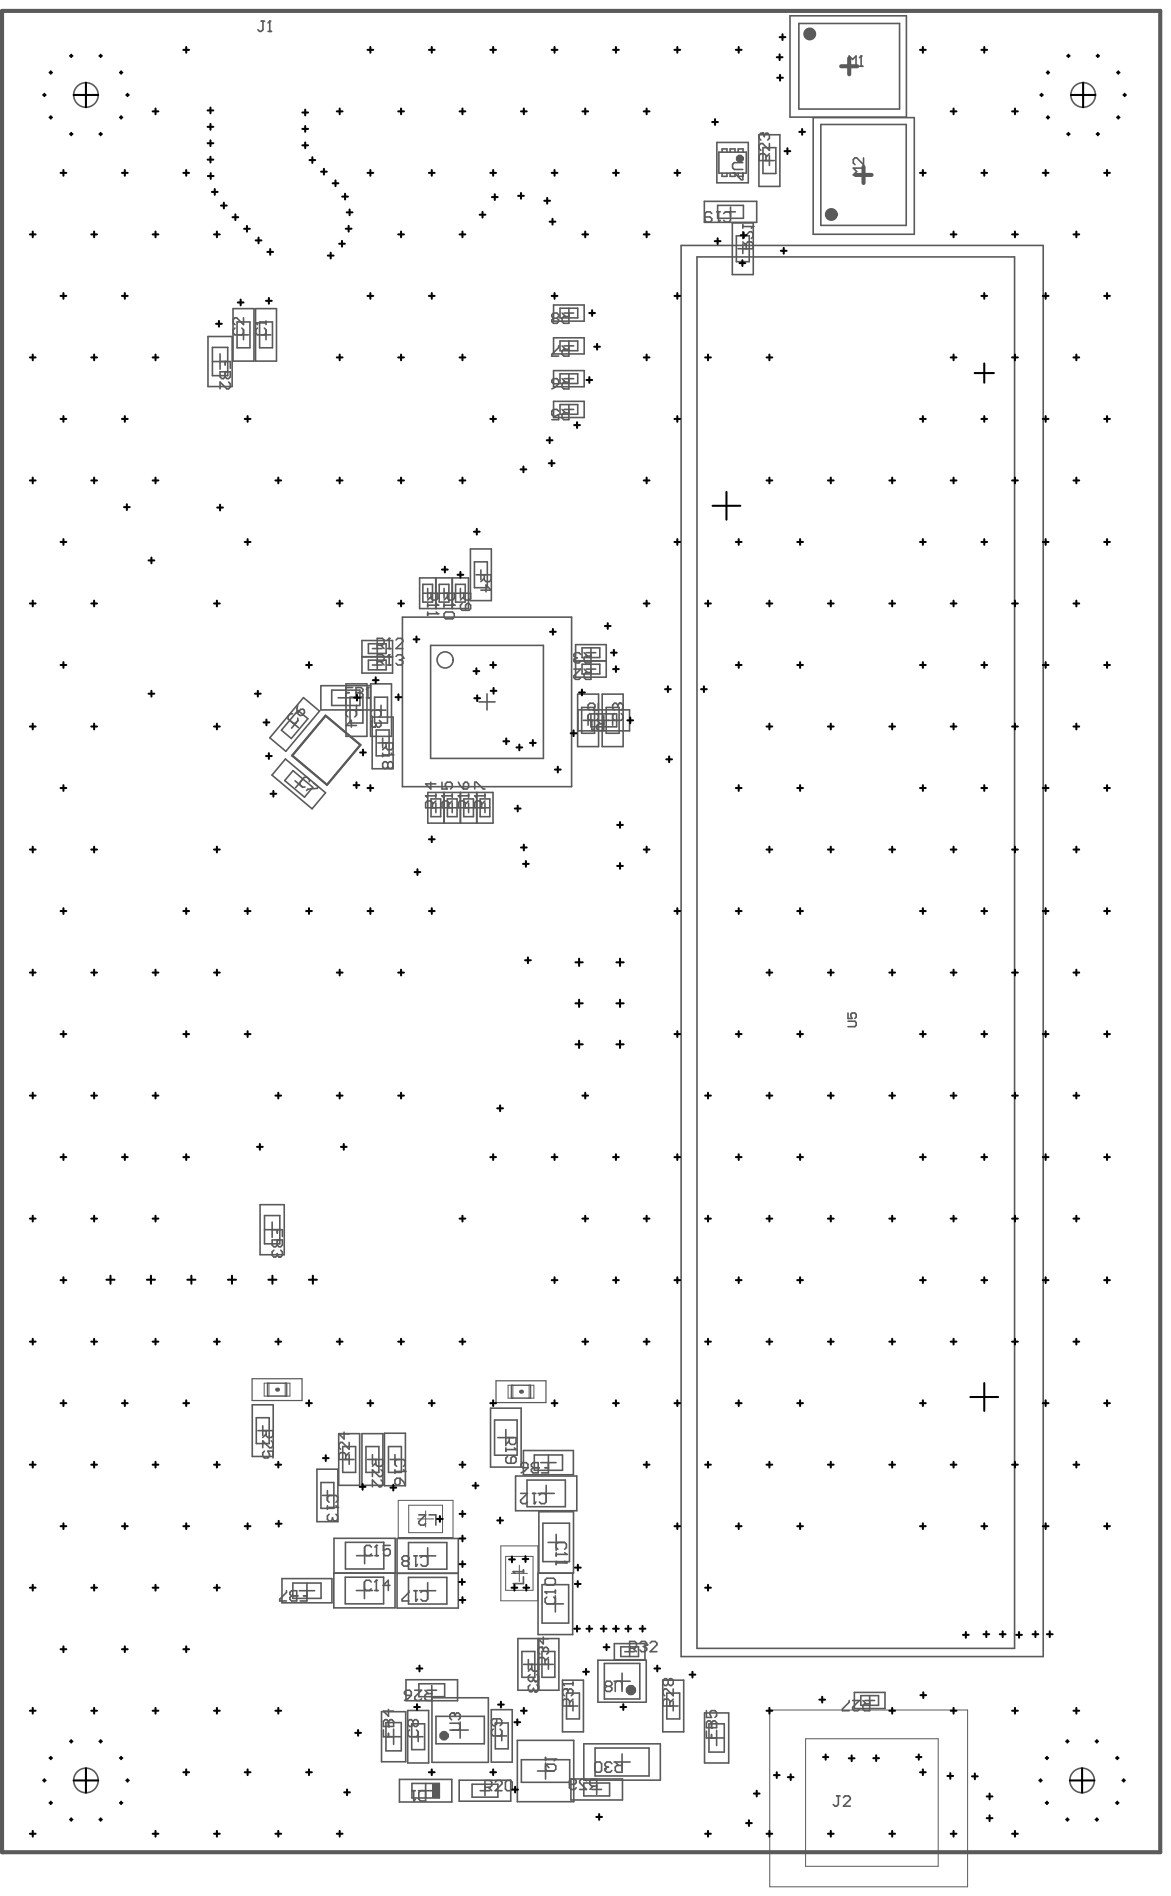
[picture p12: page 2]
