rocketman051894/LoraSMS/(list of files, drawings)

Other design files:
Hardware/01 - Main.SchDoc
Hardware/LoraSMS.PcbDoc
Hardware/LoraSMS.PcbLib
Hardware/LoraSMS.PrjPcb
Hardware/LoraSMS.SCHLIB
