rocketman051894/LoraSMS/(commit log)

2021-03-16 Initial Add
    [01 - Main.SchDoc, 330-XXXXX-XXX.SCHLIB, 340-XXXXX-XXX(set in Prj Parameters)_BoM_Output_WithDNPs.xlsx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]
2021-03-16 Naming things and cleaning up
    [01 - Main.SchDoc, 340-XXXXX-XXX(set in Prj Parameters)_BoM_Output_WithDNPs.xlsx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]
2021-03-16 More housekeeping
    [01 - Main.SchDoc, 330-XXXXX-XXX.SCHLIB, 340-XXXXX-XXX.PcbDoc, 340-XXXXX-XXX.PcbLib, LoraSMS.PcbDoc, LoraSMS.PcbLib, LoraSMS.PrjPcb, LoraSMS.SCHLIB]
2021-03-16 adding board image
